palette-system/azdice/docs/js/esptool/link.txt

https://github.com/NabuCasa/esp-web-flasher
https://unpkg.com/browse/esp-web-flasher@5.1.4/dist/web/
