palette-system/azdice/firmware/azdice4/main.jpg

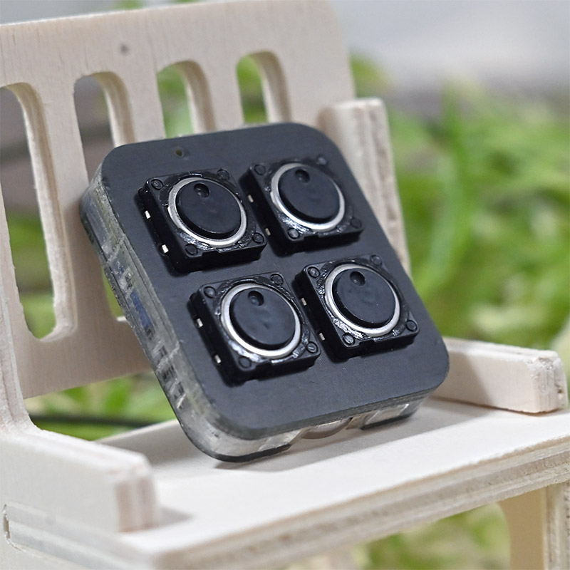
firmware/azdice4/main.jpg
