palette-system/azdice/kicad/azdice4/azdice_pcb.png

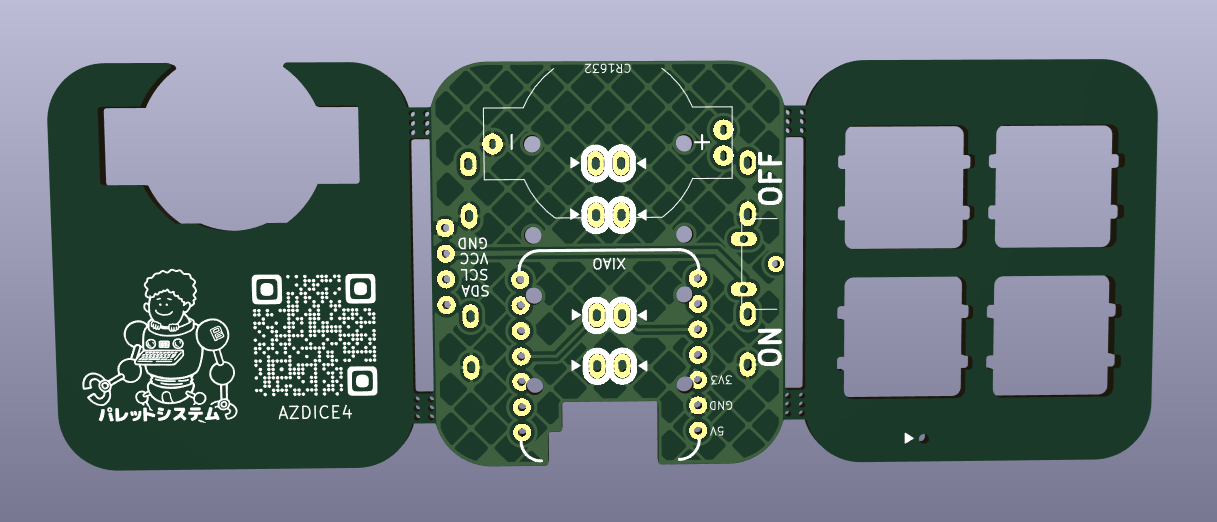
kicad/azdice4/azdice_pcb.png
