palette-system/azdice/docs/azdice4_build.html

## 必要な物

・ボンド ・マスキングテープ ・ニッパー ・ヤスリ ・はんだごて ・つまようじもあると便利

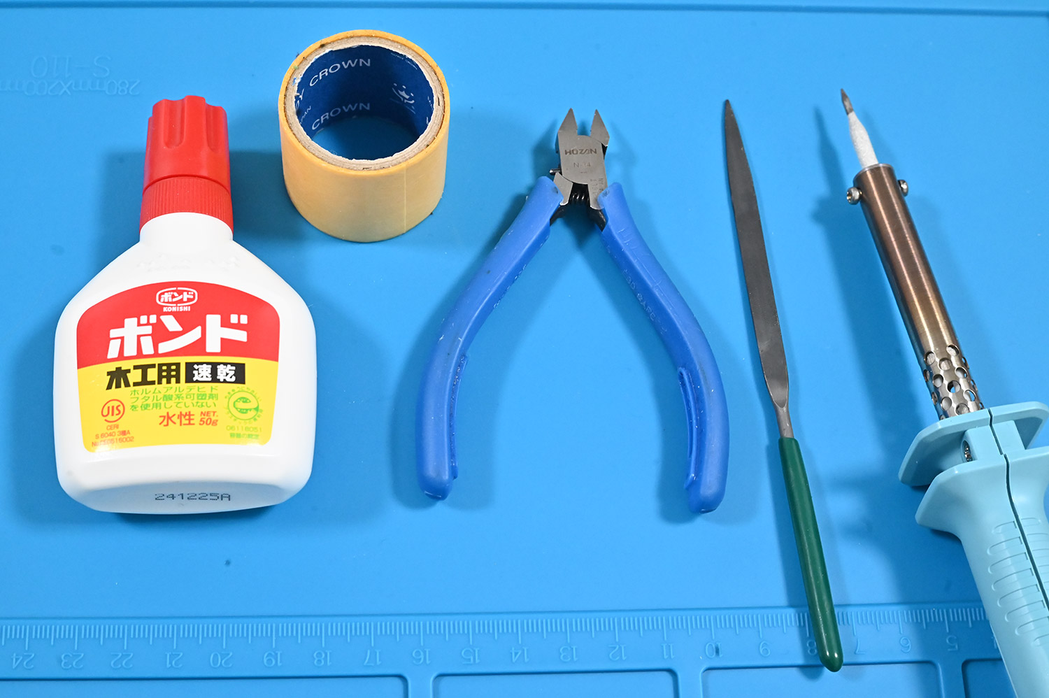
[picture p3: docs/img/azdice_4/build_00.jpg]


・Seeed XIAO BLE nRF52840 × 1個 ・アルプス12mm スイッチ × 4個

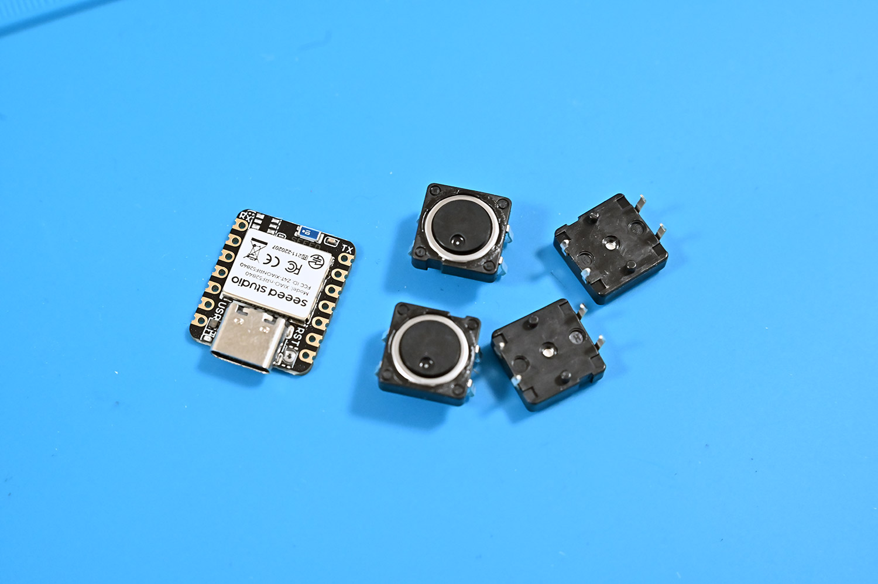
[picture p4: docs/img/azdice_4/build_02.jpg]


## 入っている物

・PCB×1 ・ボトムプレート×1 ・ミドルプレート×1 ・トッププレート×1 ・電池ホルダー×1 ・スライドスイッチ×1 ・細ピンヘッダ×2 ・輪ゴム×1

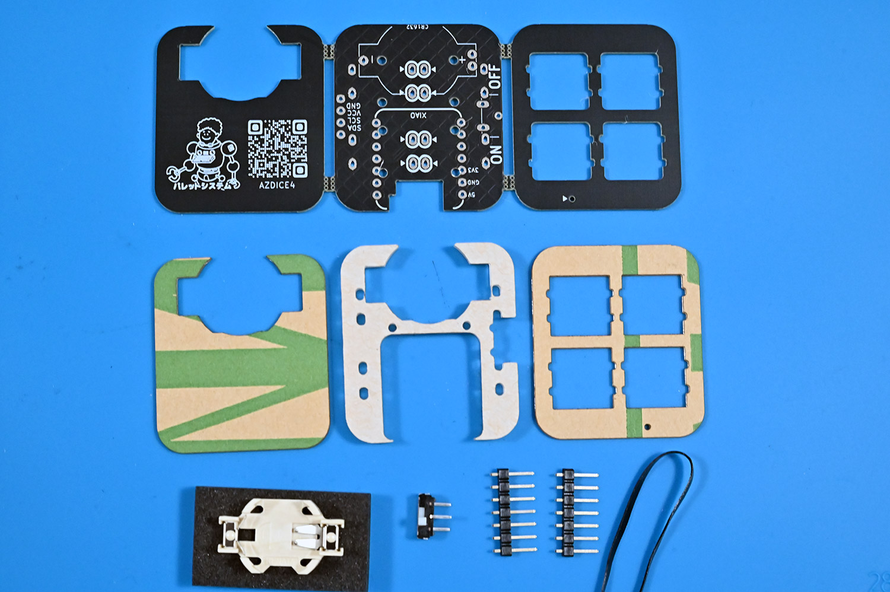
[picture p5: docs/img/azdice_4/build_01.jpg]


## １．PCBのカット

PCBを手で折って、ニッパーやヤスリで切り口を綺麗にします。

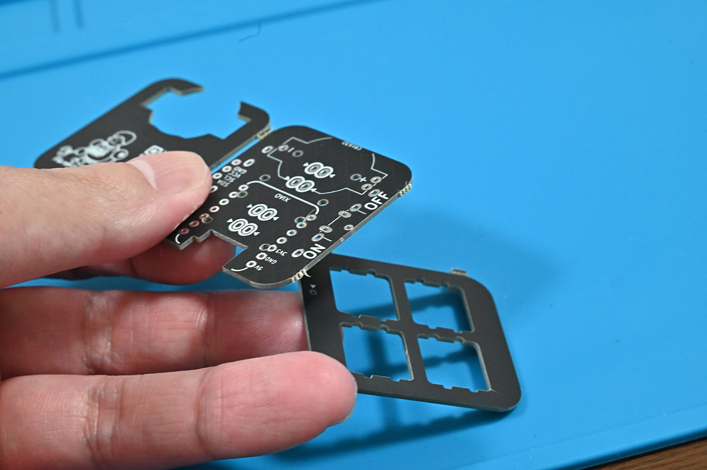
[picture p6: docs/img/azdice_4/build_03.jpg]


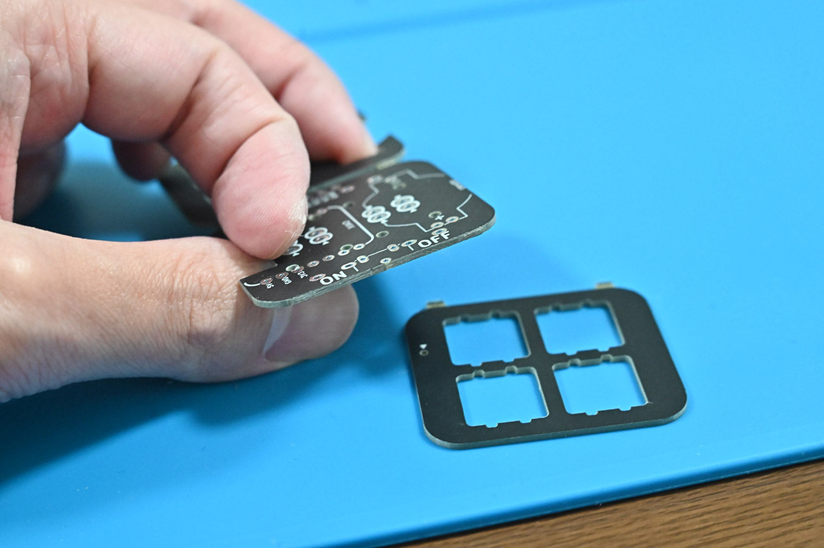
[picture p7: docs/img/azdice_4/build_04.jpg]


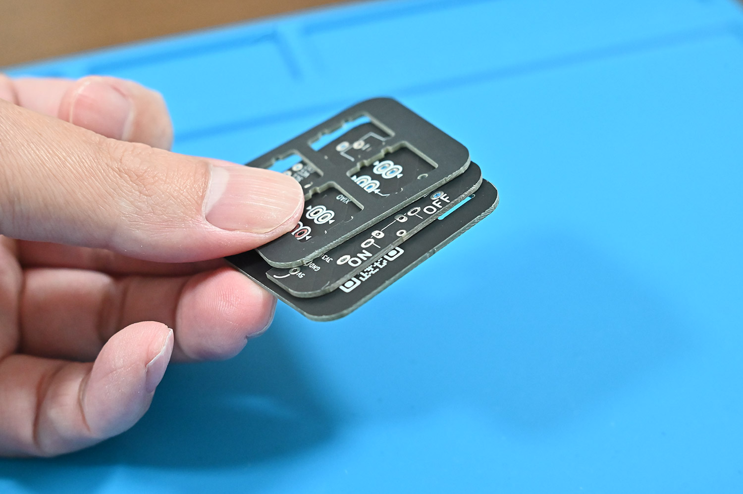
[picture p8: docs/img/azdice_4/build_05.jpg]


## ２．細ピンヘッダのカット

細ピンヘッダの短い方を1mmくらい残してカットします。

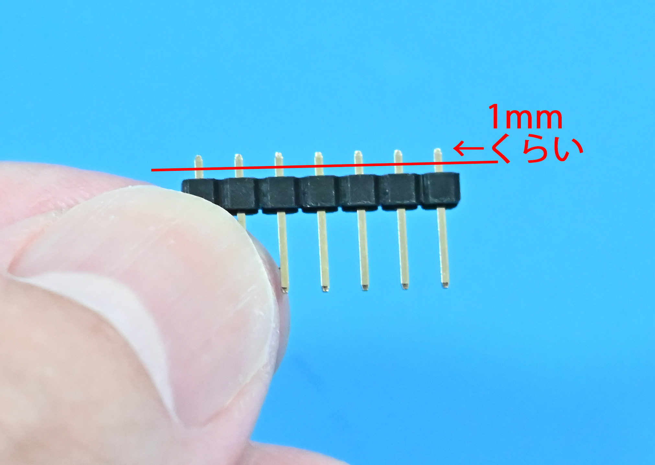
[picture p9: docs/img/azdice_4/build_06.jpg]


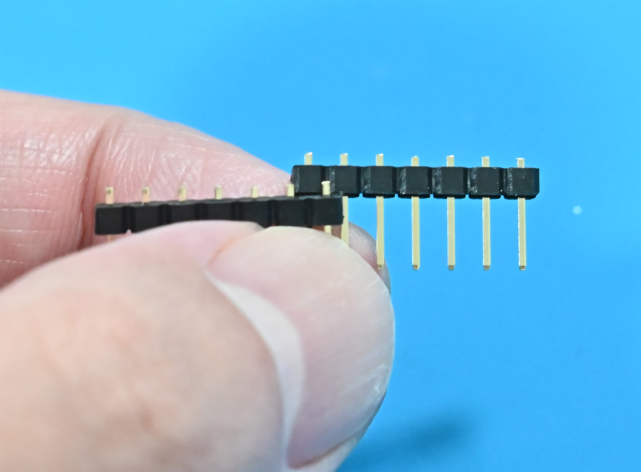
[picture p10: docs/img/azdice_4/build_07.jpg]


## ３．細ピンヘッダのはんだ付け

PCBの裏に細ピンヘッダを立てます。

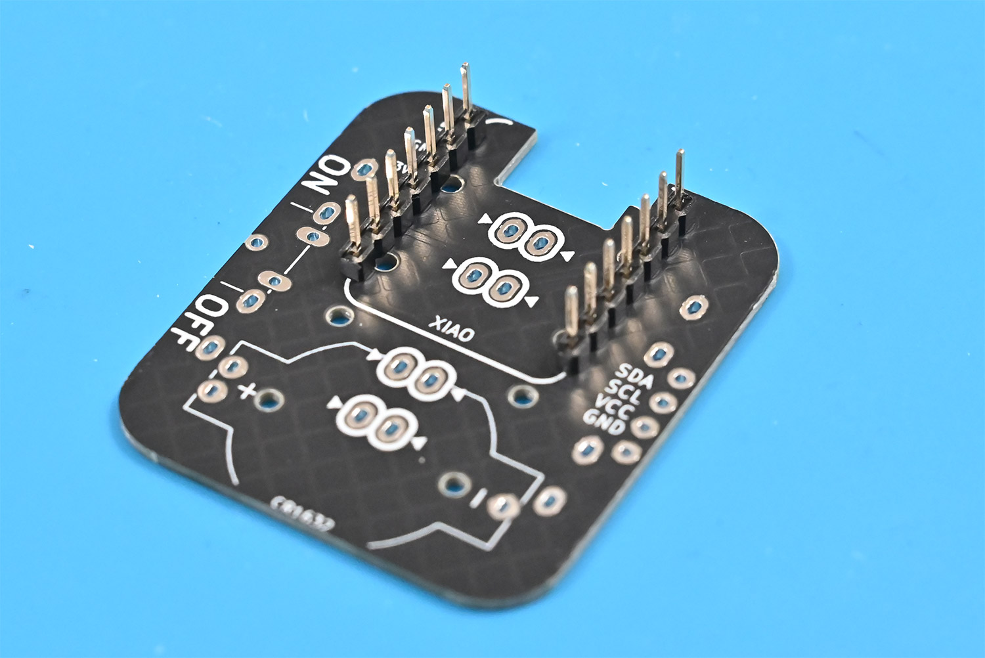
[picture p11: docs/img/azdice_4/build_08.jpg]


XIAOを乗せてゴムでとめます。

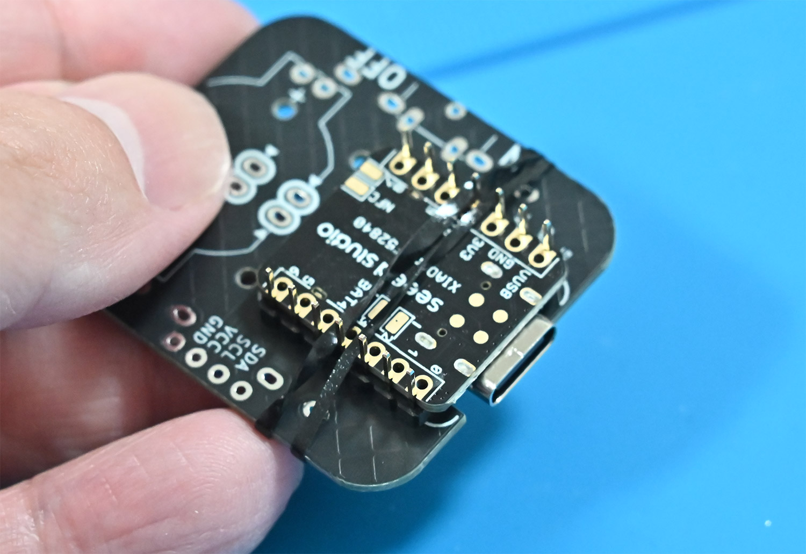
[picture p12: docs/img/azdice_4/build_09.jpg]


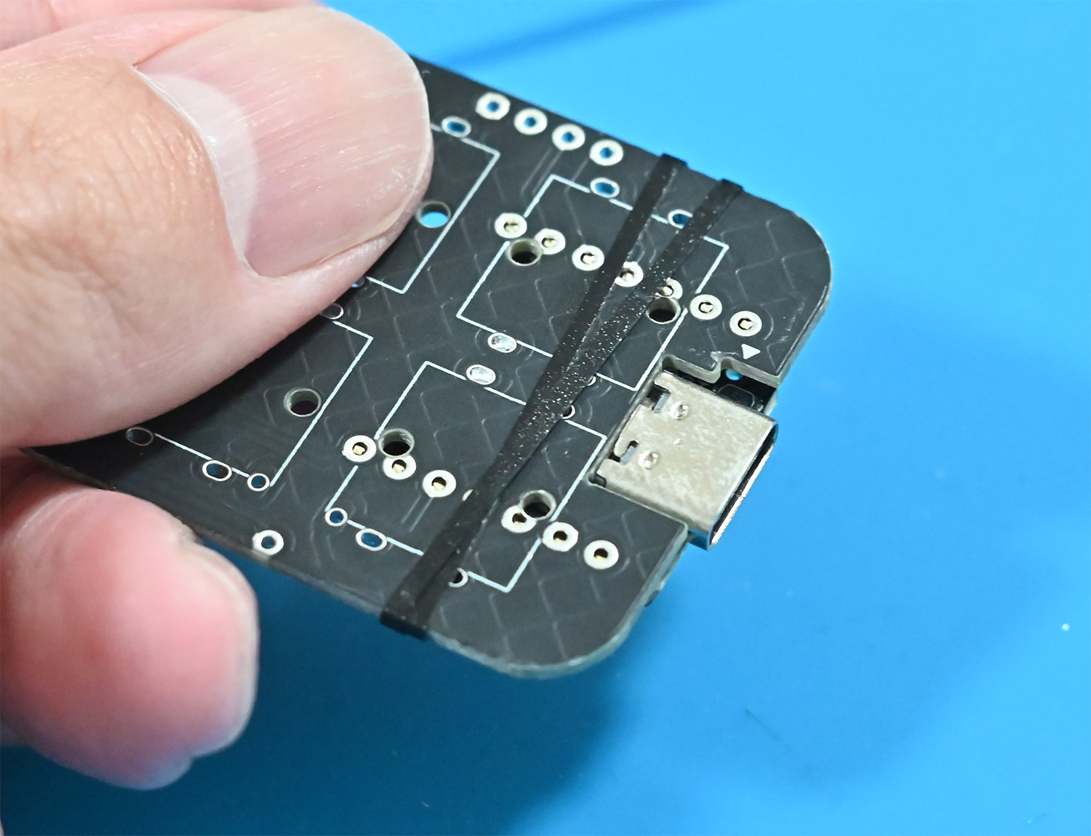
[picture p13: docs/img/azdice_4/build_10.jpg]


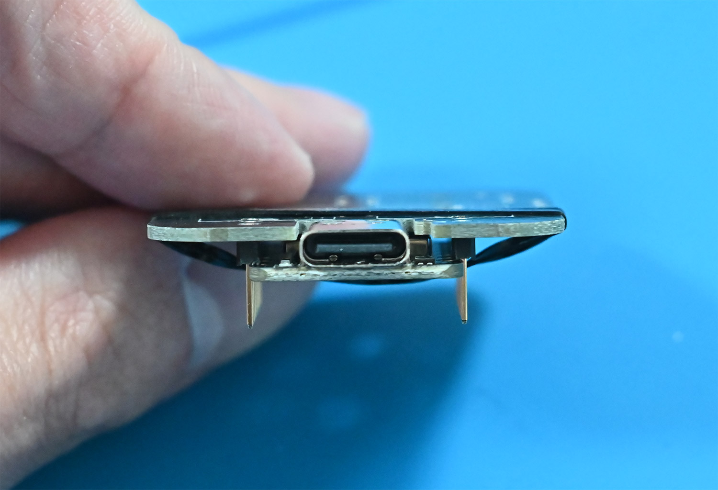
[picture p14: docs/img/azdice_4/build_11.jpg]


4つ端をはんだ付けして固定します。

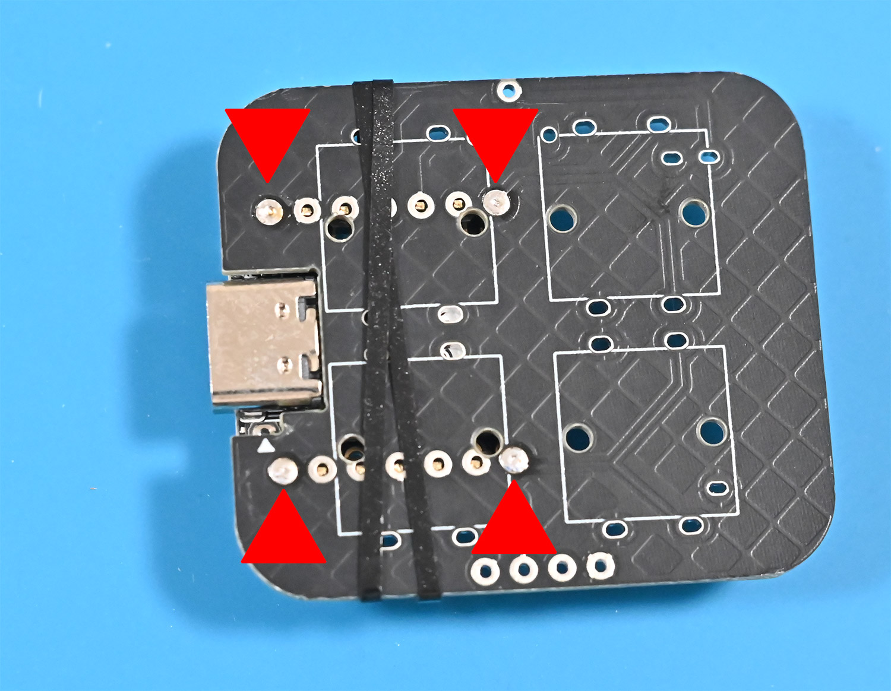
[picture p15: docs/img/azdice_4/build_12.jpg]


ゴムを外して全てのピンをはんだ付けします。
出っ張りができないようにはんだ付けして下さい。

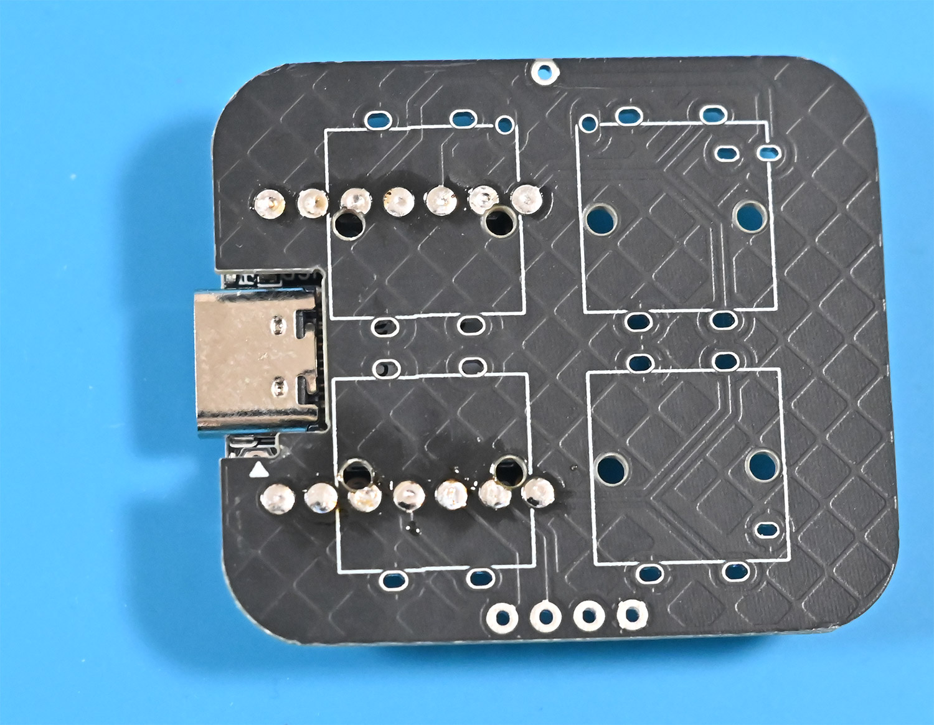
[picture p16: docs/img/azdice_4/build_13.jpg]


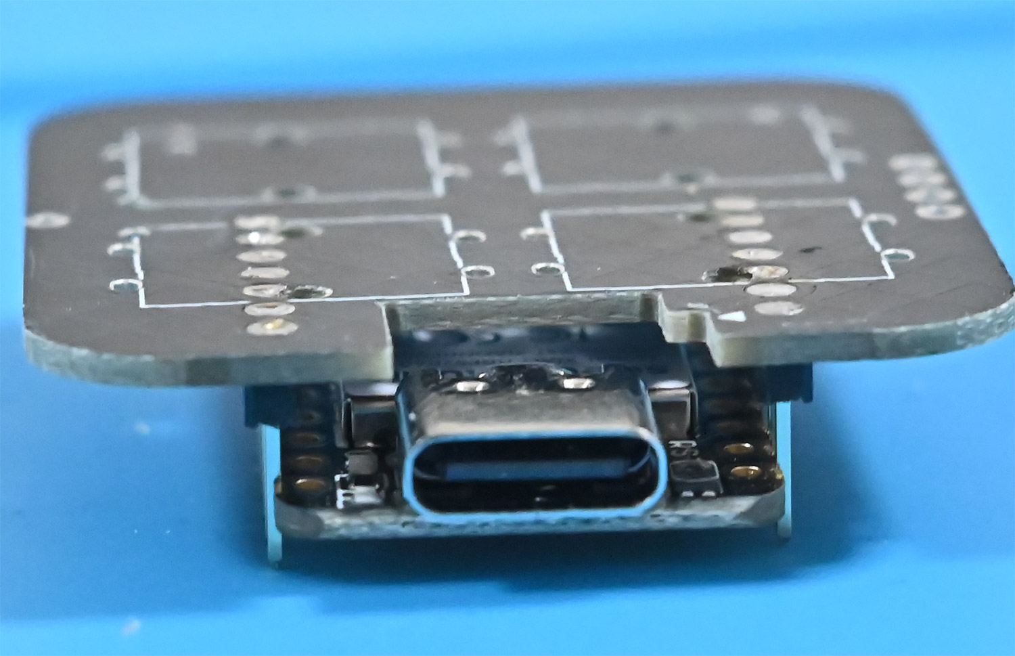
[picture p17: docs/img/azdice_4/build_14.jpg]


## ４．スイッチのカット

スイッチの足と固定用のプラスチック部分を1mmくらい残してカットします。
4個全てのスイッチを同様にカットして下さい。

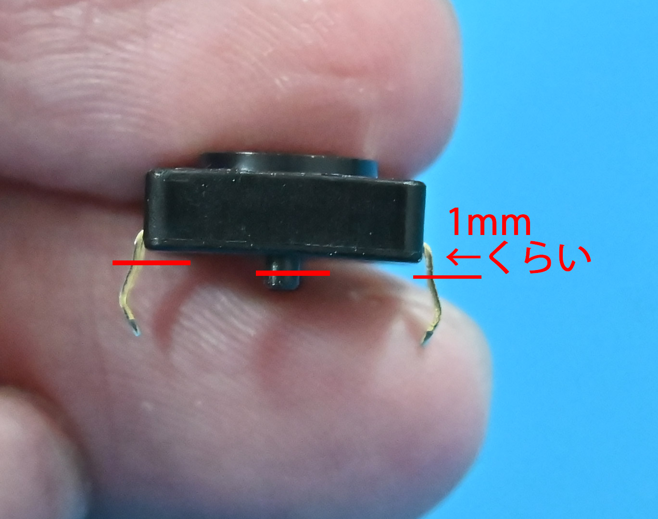
[picture p18: docs/img/azdice_4/build_15.jpg]


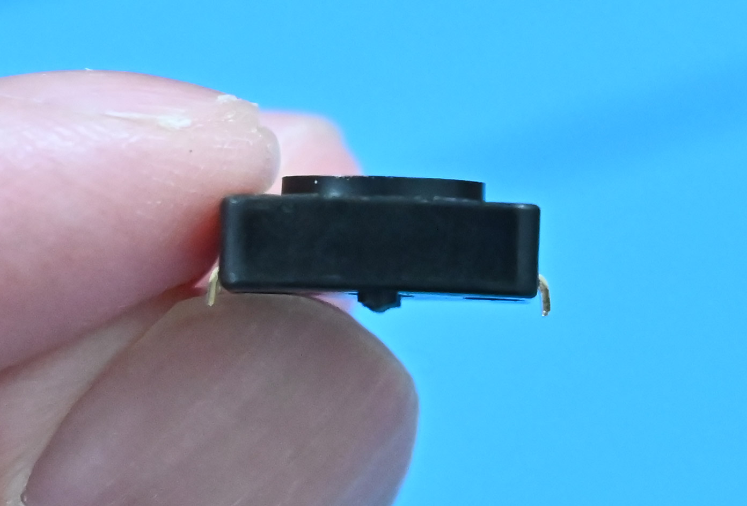
[picture p19: docs/img/azdice_4/build_16.jpg]


## ５．スイッチのはんだ付け

スイッチを固定してマスキングテープでとめます。

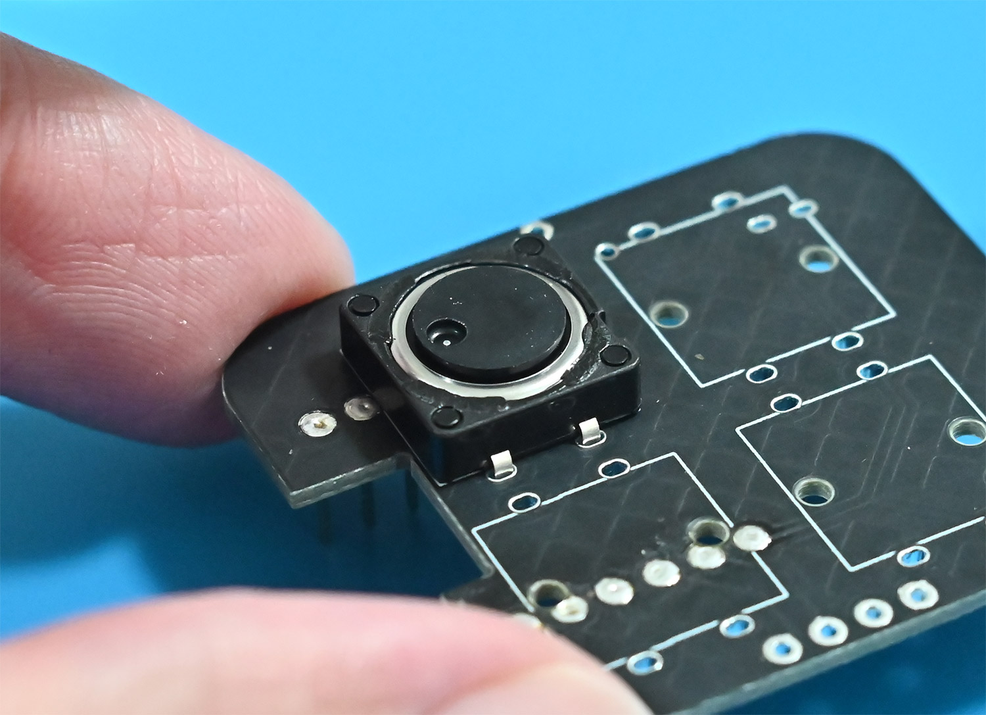
[picture p20: docs/img/azdice_4/build_17.jpg]


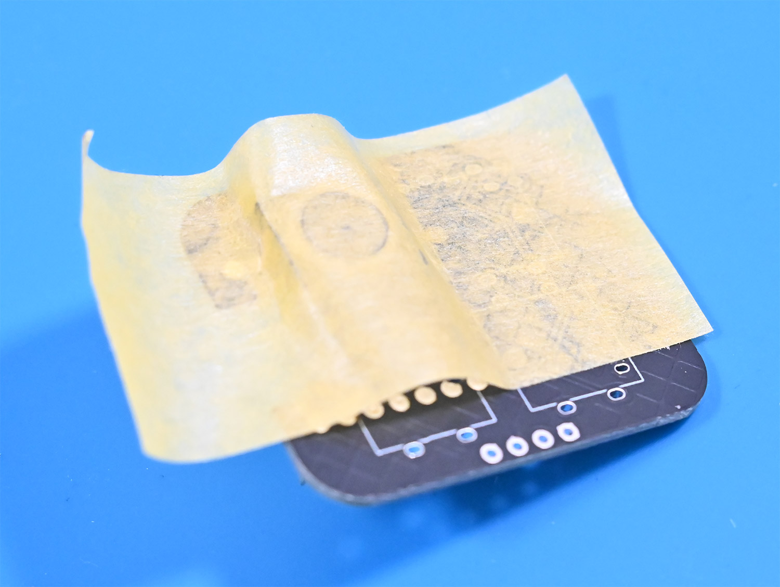
[picture p21: docs/img/azdice_4/build_18.jpg]


裏面からピンが出っ張らないようにはんだ付けします。
ピンが長すぎた場合は出っ張りができないようピンを短くカットして下さい。

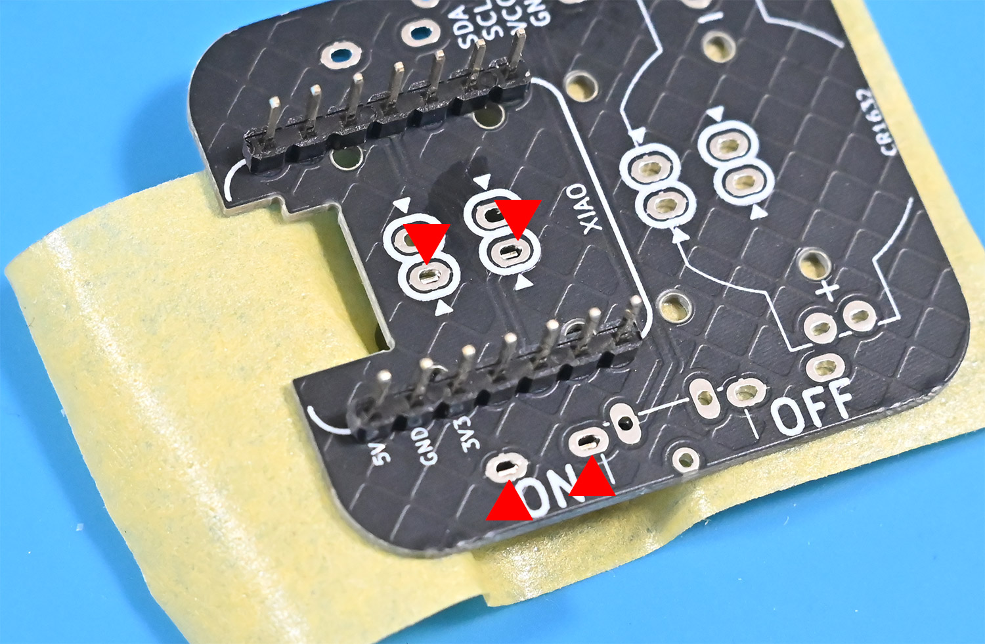
[picture p22: docs/img/azdice_4/build_19.jpg]


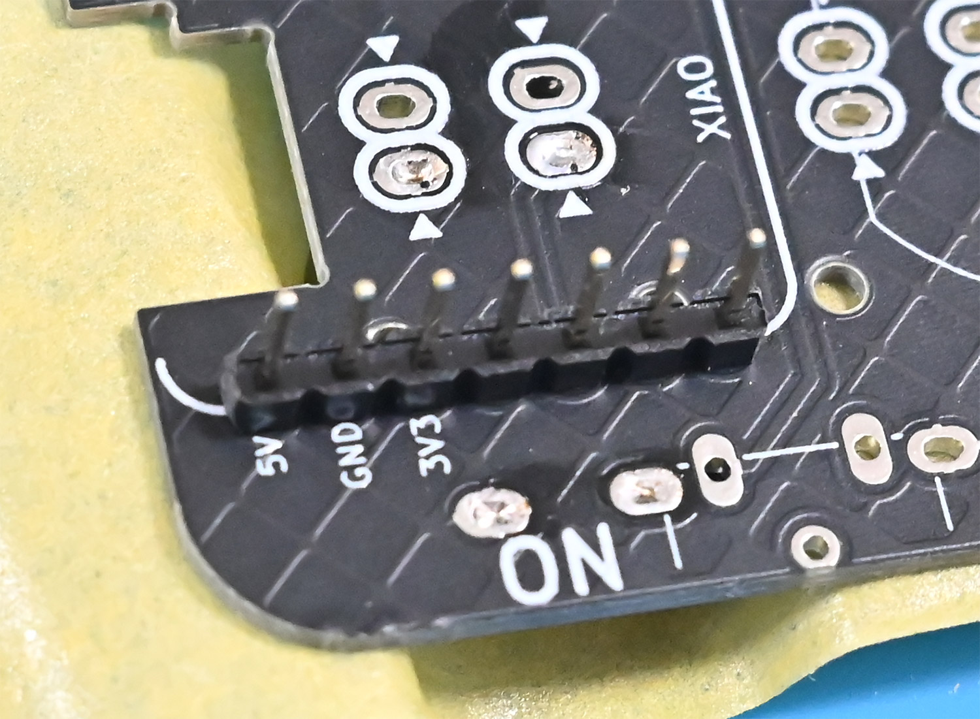
[picture p23: docs/img/azdice_4/build_20.jpg]


同様に4個全てのスイッチをはんだ付けします。

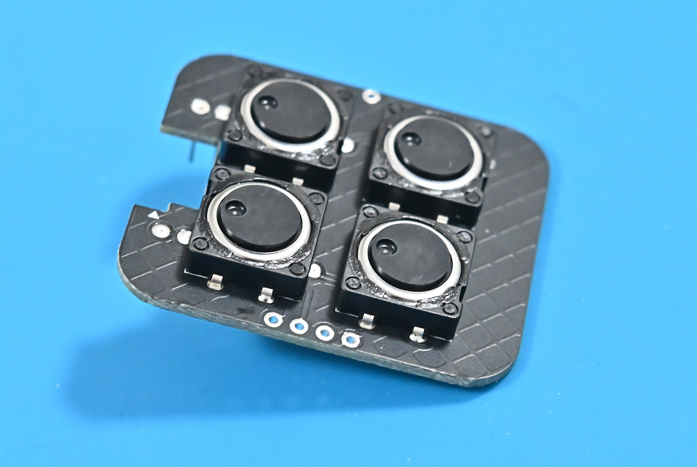
[picture p24: docs/img/azdice_4/build_21.jpg]


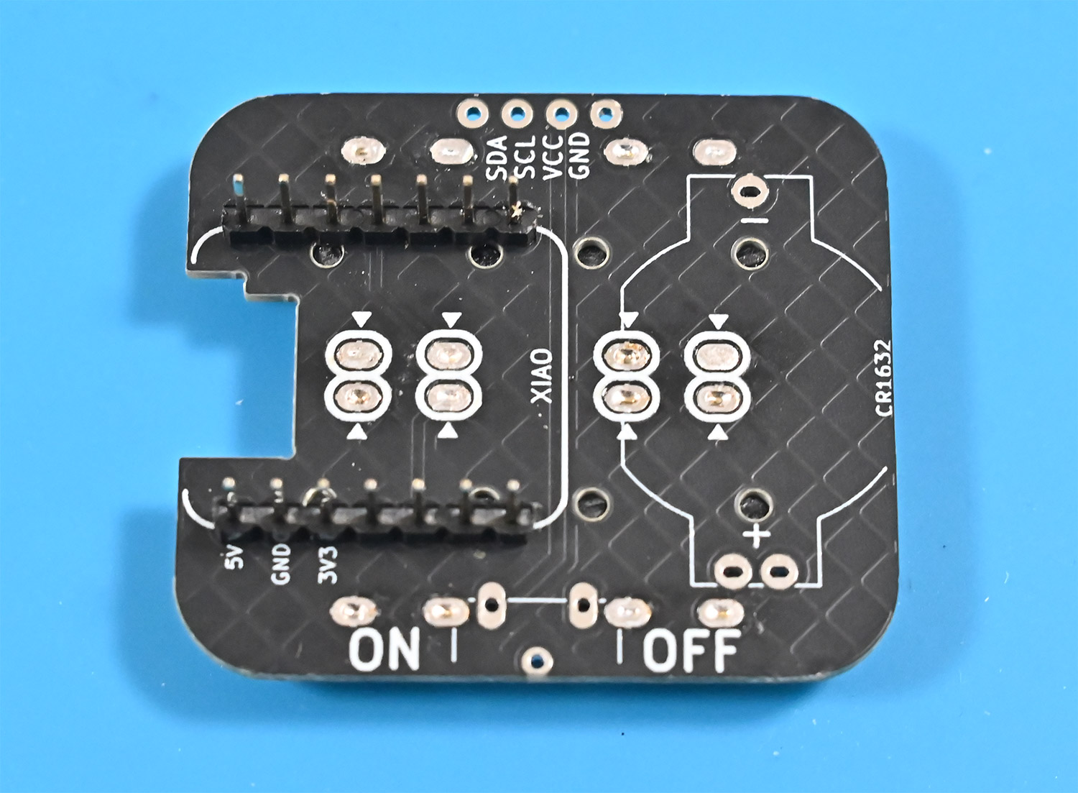
[picture p25: docs/img/azdice_4/build_22.jpg]


## ６．スライドスイッチのカット

スライドスイッチの足を1mmくらい残してカットします。

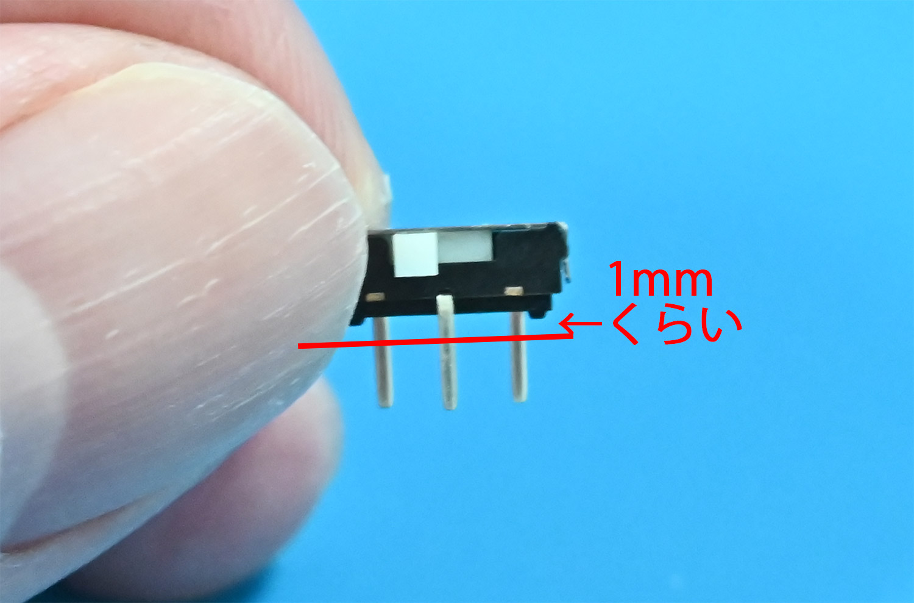
[picture p26: docs/img/azdice_4/build_23.jpg]


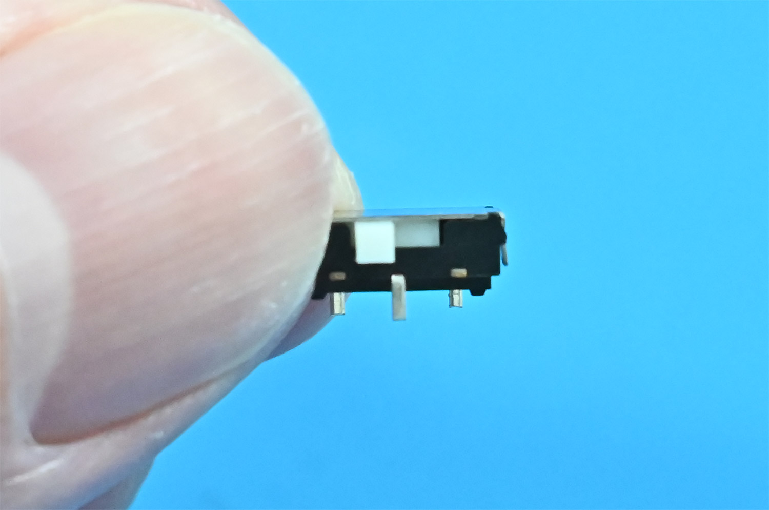
[picture p27: docs/img/azdice_4/build_24.jpg]


## ７．スライドスイッチのはんだ付け

裏面にスライドスイッチを置いて、後ろ側2か所をはんだ付けします。

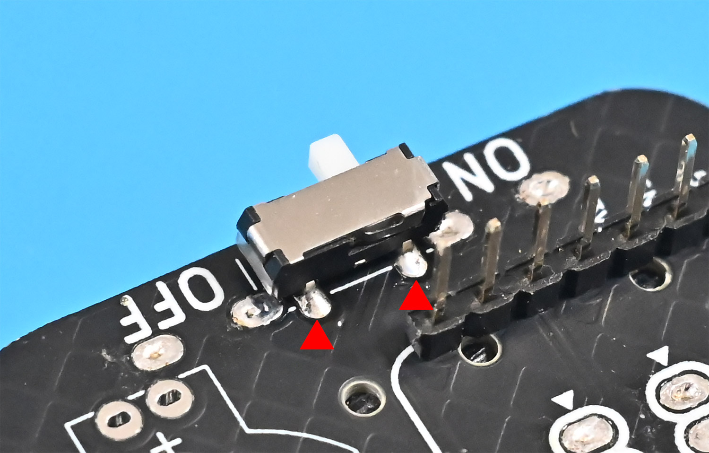
[picture p28: docs/img/azdice_4/build_25.jpg]


表面から前側1か所をはんだ付けします。

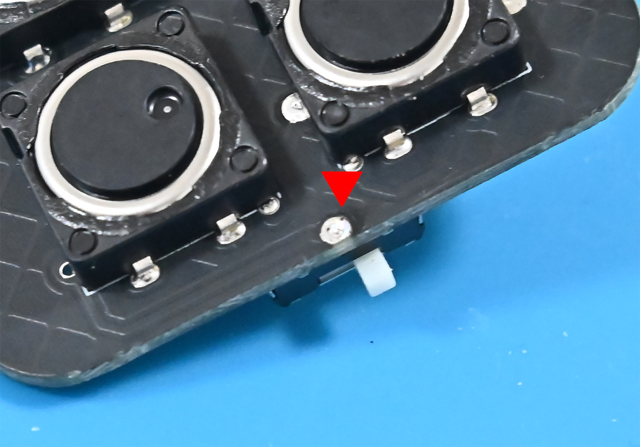
[picture p29: docs/img/azdice_4/build_26.jpg]


## ８．XIAOのはんだ付け

裏面にXIAOを置いて、細ピンヘッダの出っ張ってる部分をカットします。
出っ張りができないようにカットして下さい。

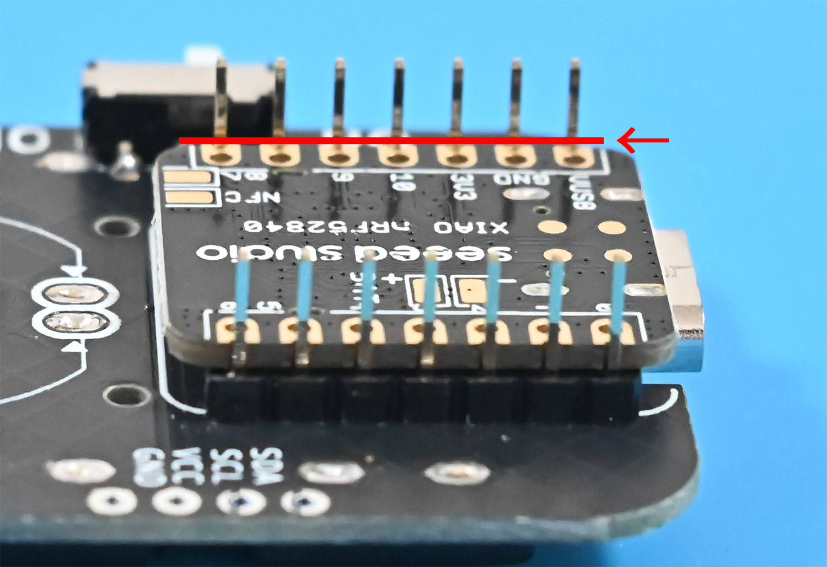
[picture p30: docs/img/azdice_4/build_27.jpg]


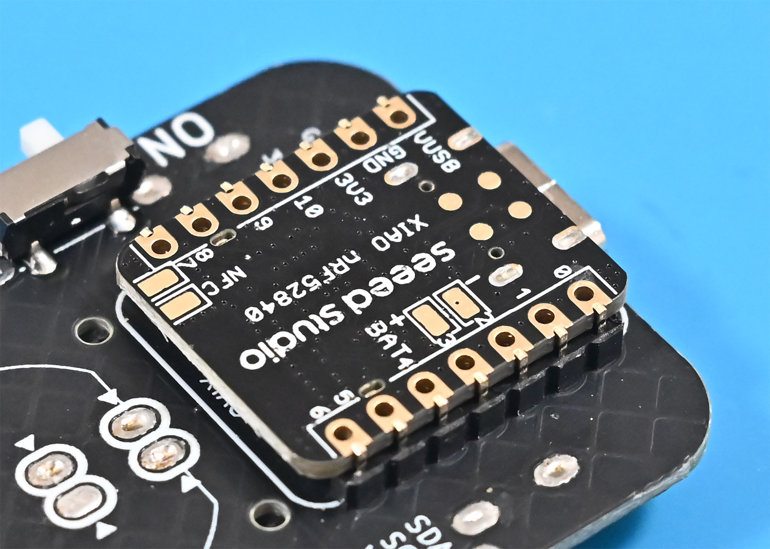
[picture p31: docs/img/azdice_4/build_28.jpg]


細ピンヘッダとXIAOをはんだ付けします。

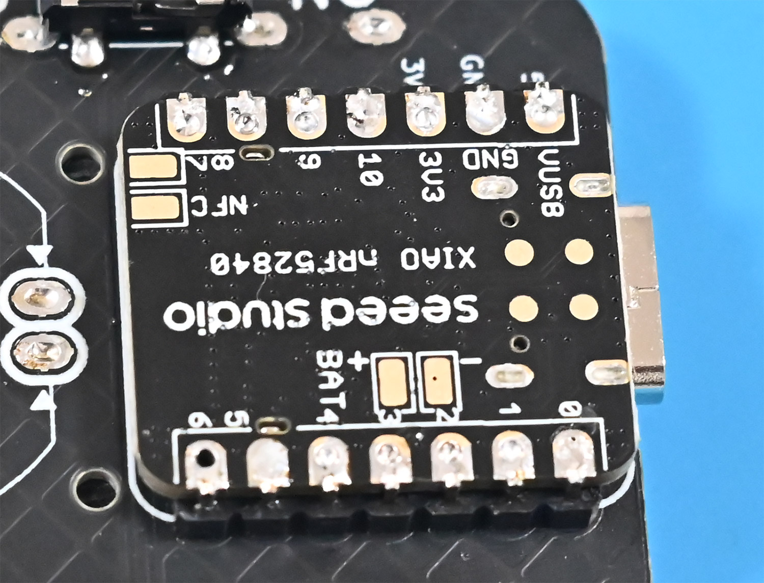
[picture p32: docs/img/azdice_4/build_29.jpg]


## ９．電池ホルダーのはんだ付け

電池ホルダーの足を1mmくらい残してカットします。

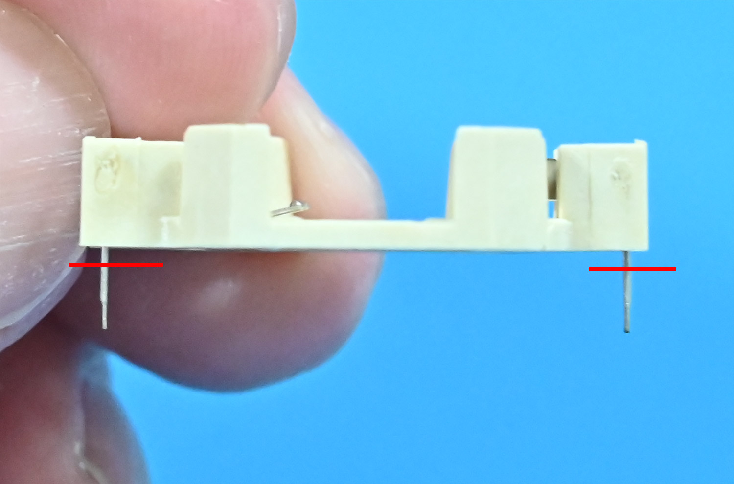
[picture p33: docs/img/azdice_4/build_30.jpg]


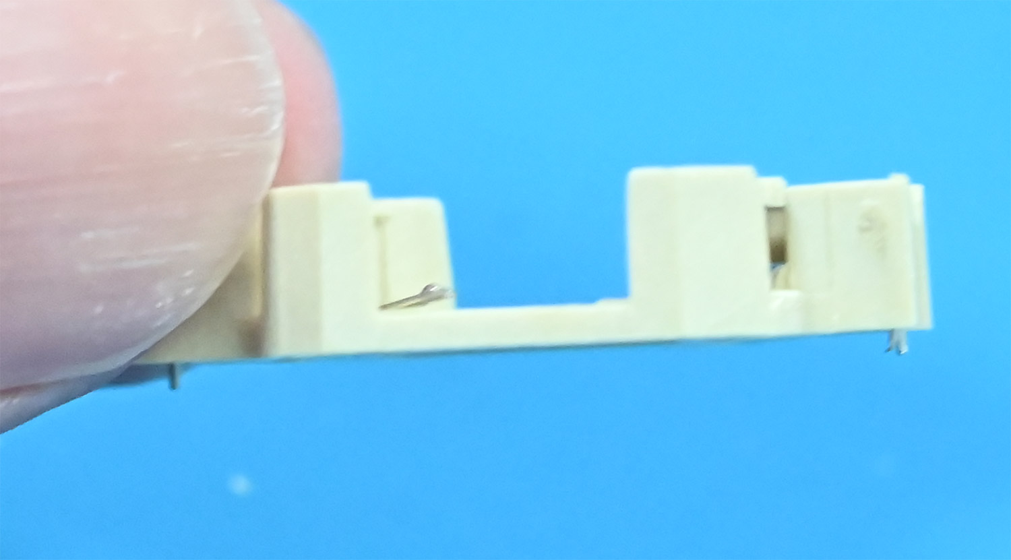
[picture p34: docs/img/azdice_4/build_31.jpg]


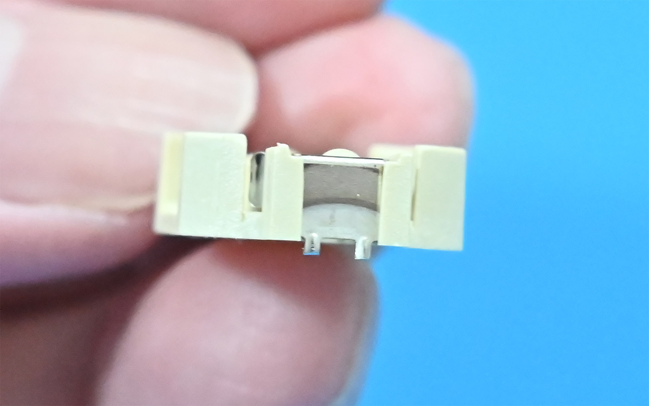
[picture p35: docs/img/azdice_4/build_32.jpg]


PCBの裏面に電池ホルダーを置いて両端をはんだ付けして下さい。

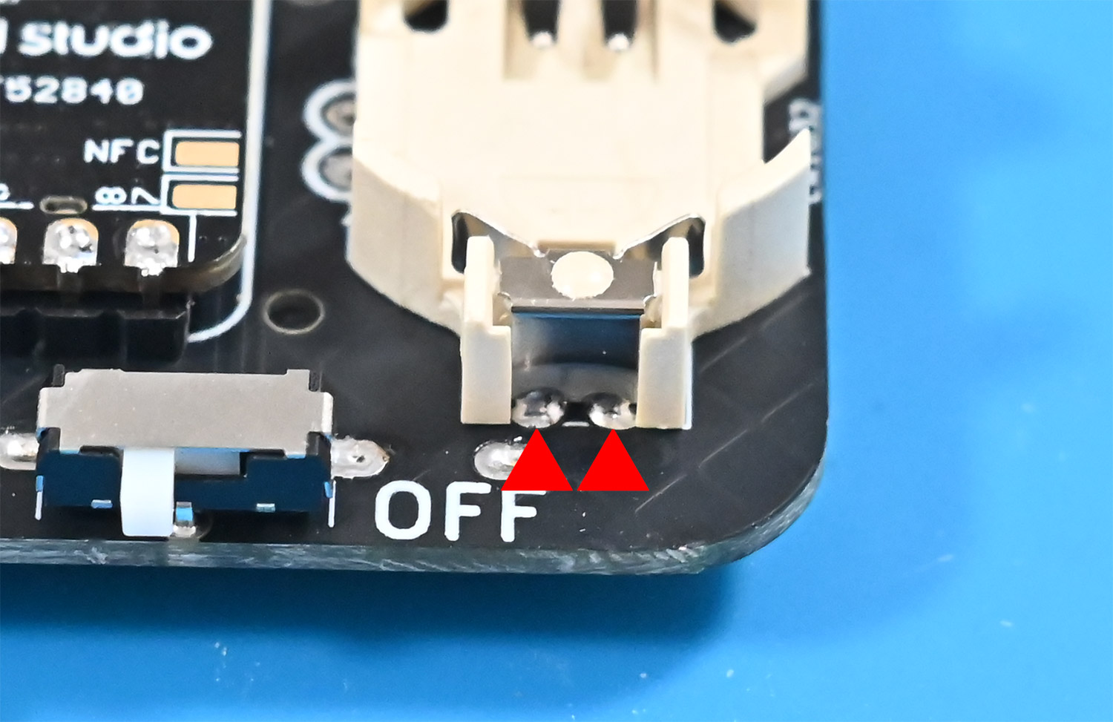
[picture p36: docs/img/azdice_4/build_33.jpg]


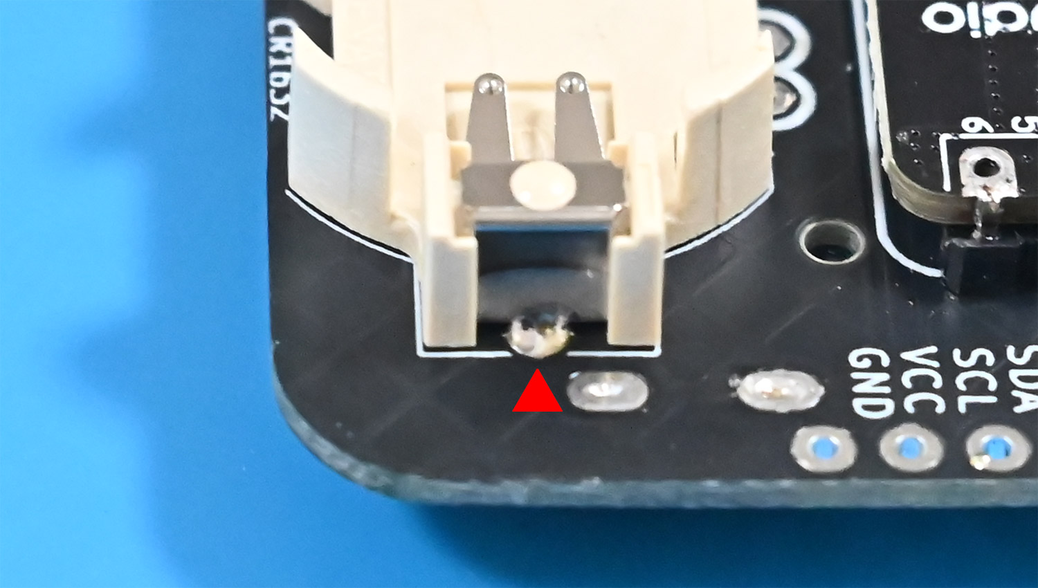
[picture p37: docs/img/azdice_4/build_34.jpg]


## １０．ファームウェアの書き込み

XIAOをPCに接続して、下記リンク先を参考にファームウェアを書き込んでキーボードとして動作する事を確認して下さい。

ファームウェア書込 (https://palette-system.github.io/azk/nrf52840.html)

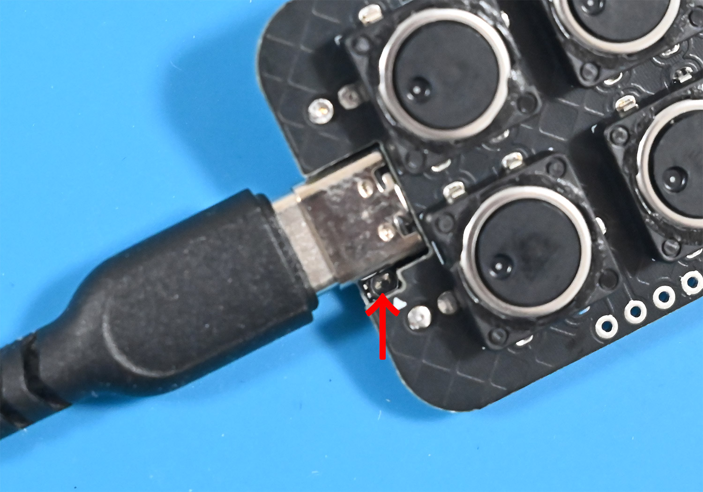
[picture p38: docs/img/azdice_4/build_35.jpg]


## １１．プレートの仮止め

使用するプレートの保護シートを剥がします。

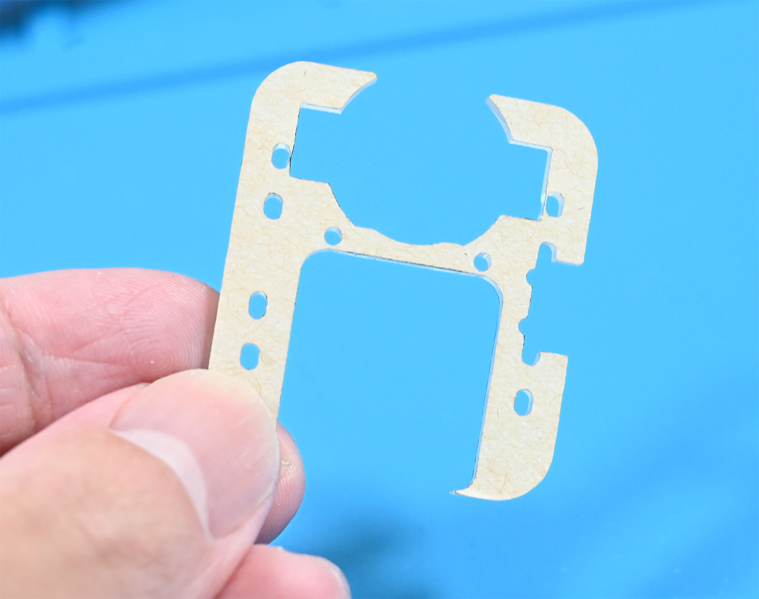
[picture p39: docs/img/azdice_4/build_36.jpg]


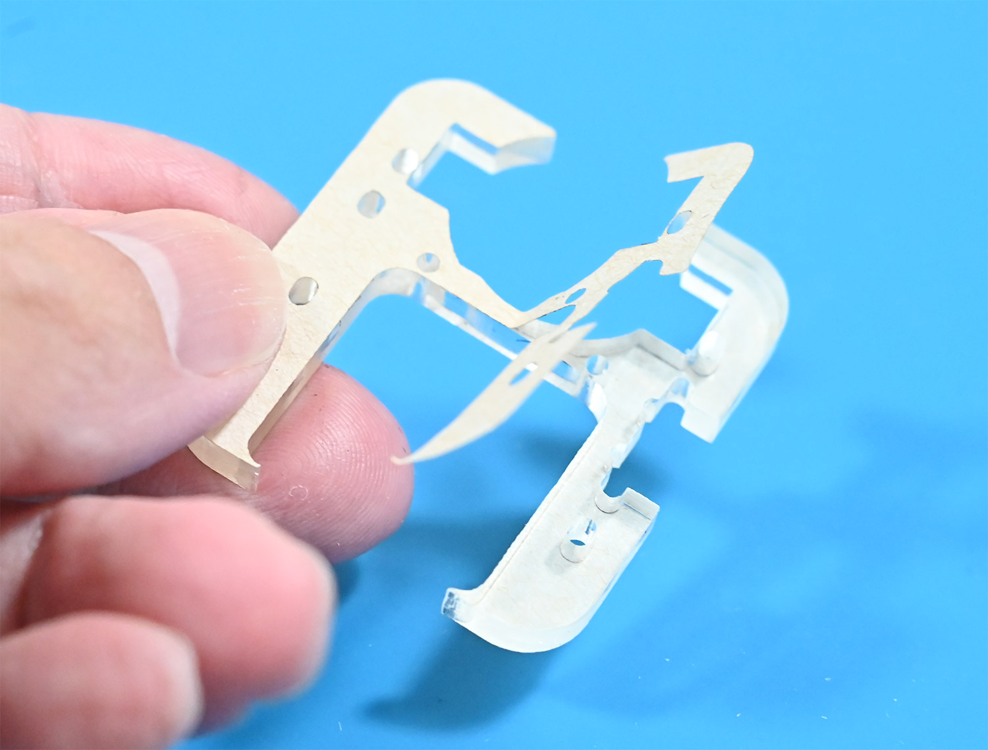
[picture p40: docs/img/azdice_4/build_37.jpg]


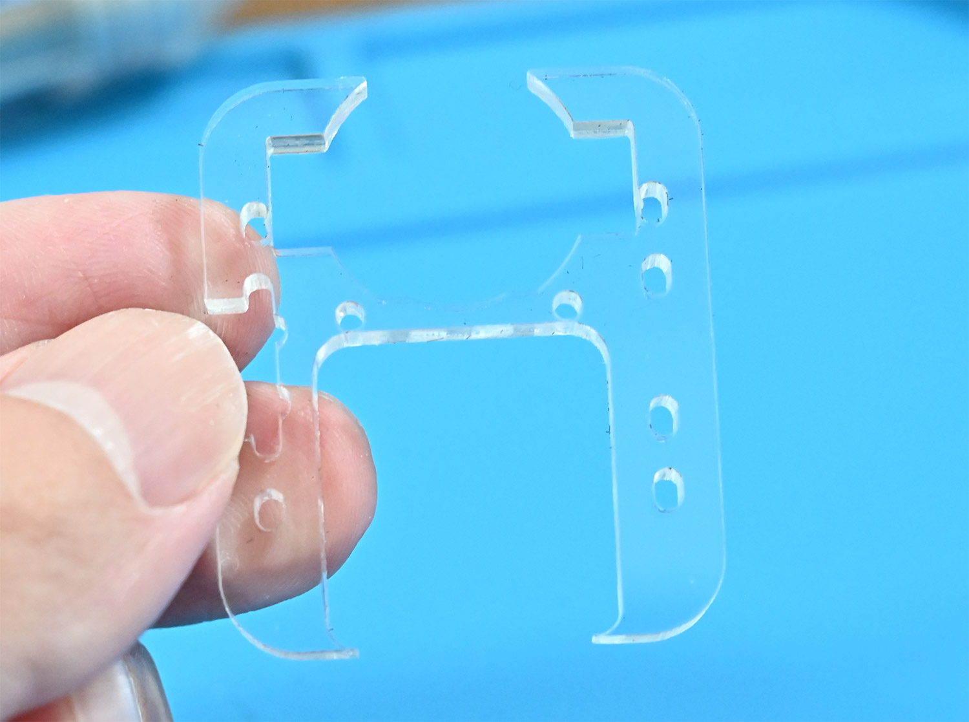
[picture p41: docs/img/azdice_4/build_38.jpg]


裏面にミドルプレートを重ねます。

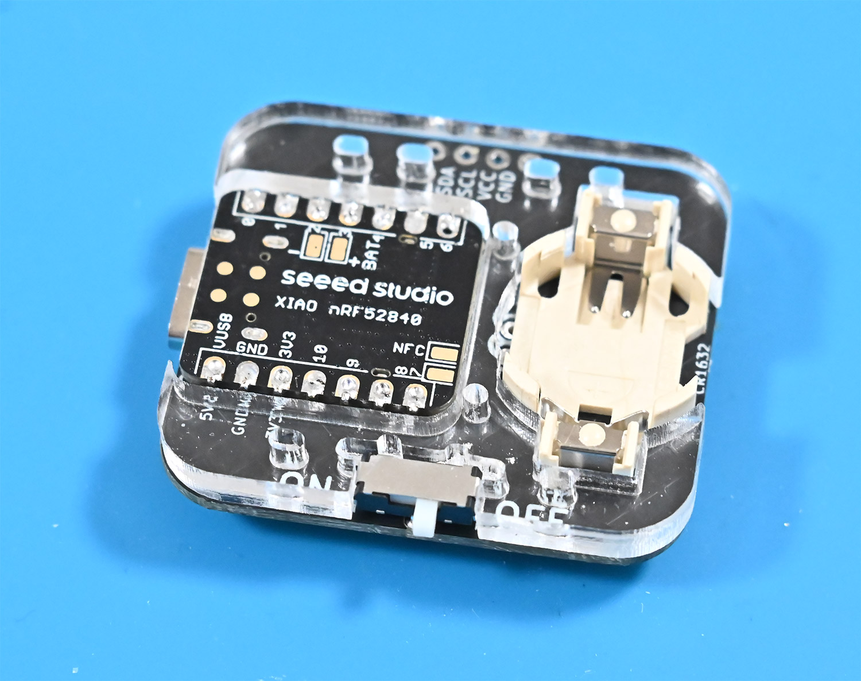
[picture p42: docs/img/azdice_4/build_39.jpg]


ミドルプレートの上にボトムプレートを重ねます。
※透明にしたい場合はアクリルのボトムプレートを重ねて下さい。

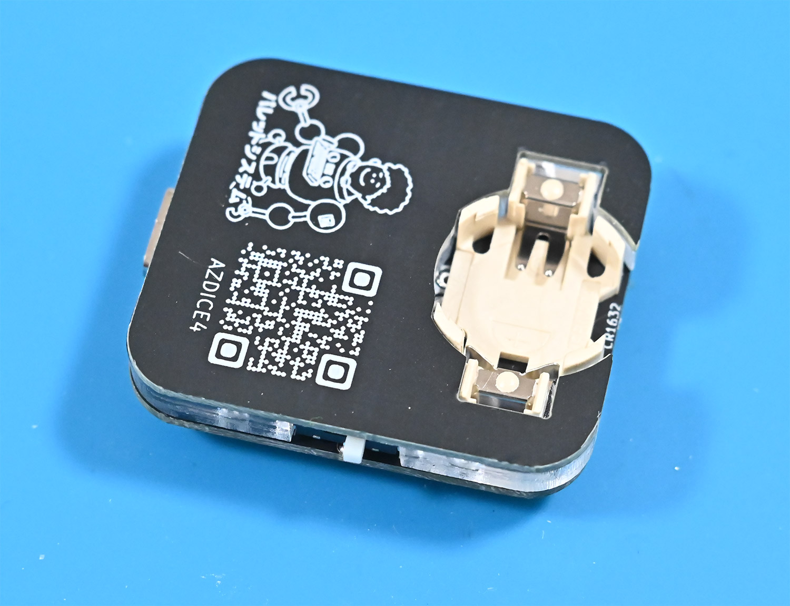
[picture p43: docs/img/azdice_4/build_40.jpg]


表面にしてトッププレートを重ねます。
XIAOのリセットボタンを押す用の穴があるので向きに気を付けて下さい。
※透明にしたい場合はアクリルのトッププレートを重ねて下さい。

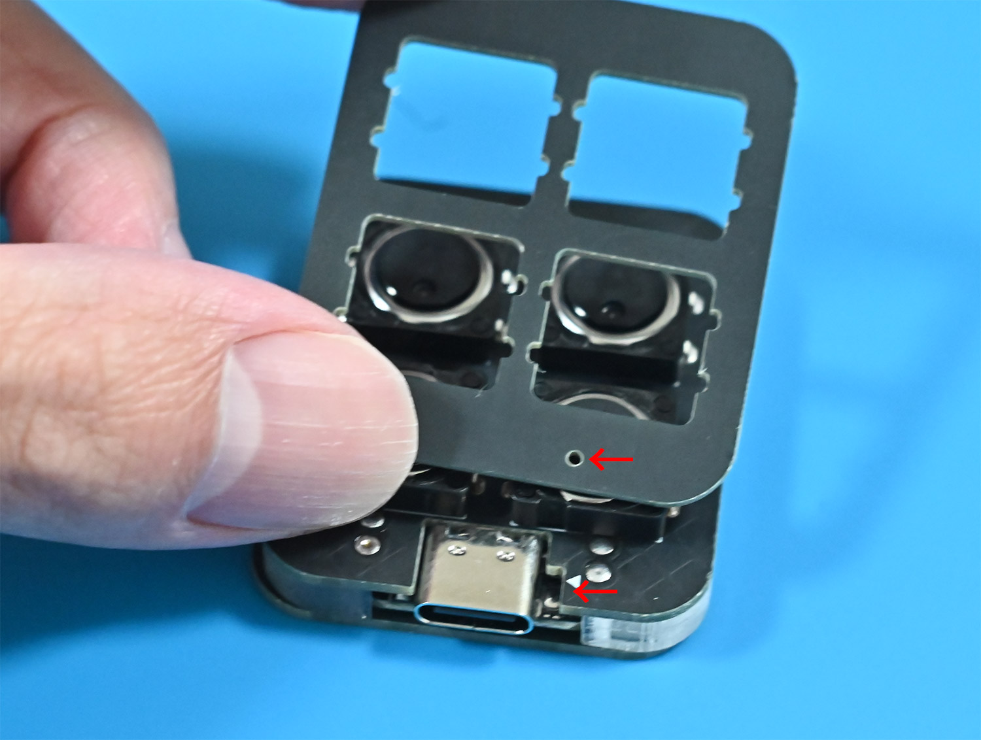
[picture p44: docs/img/azdice_4/build_41.jpg]


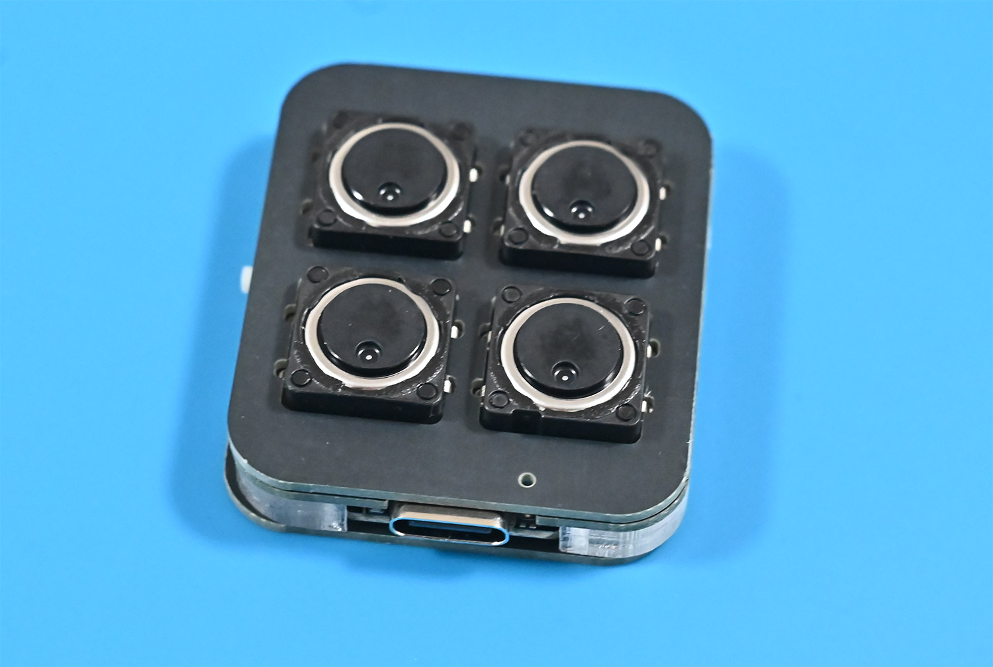
[picture p45: docs/img/azdice_4/build_42.jpg]


マスキングテープで左右を止めて下さい。

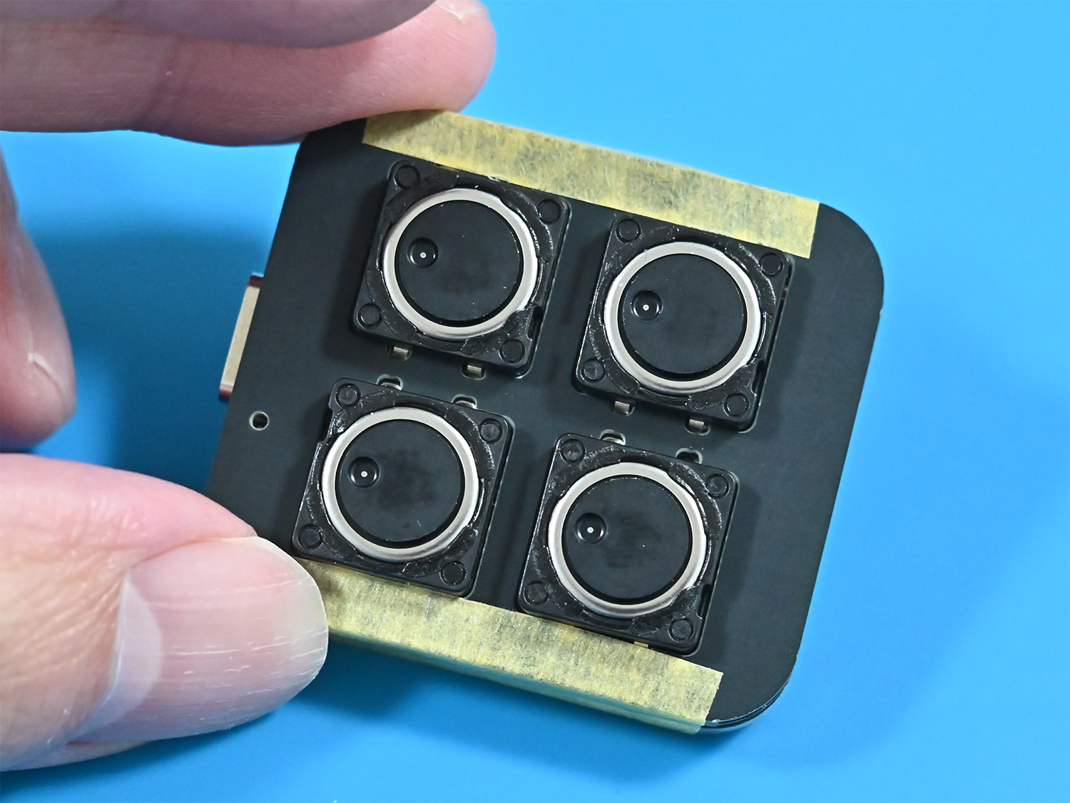
[picture p46: docs/img/azdice_4/build_43.jpg]


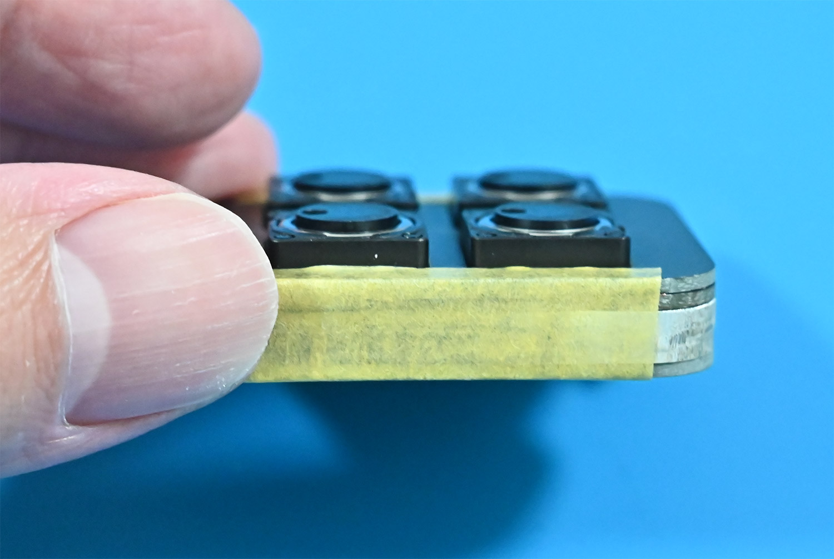
[picture p47: docs/img/azdice_4/build_44.jpg]


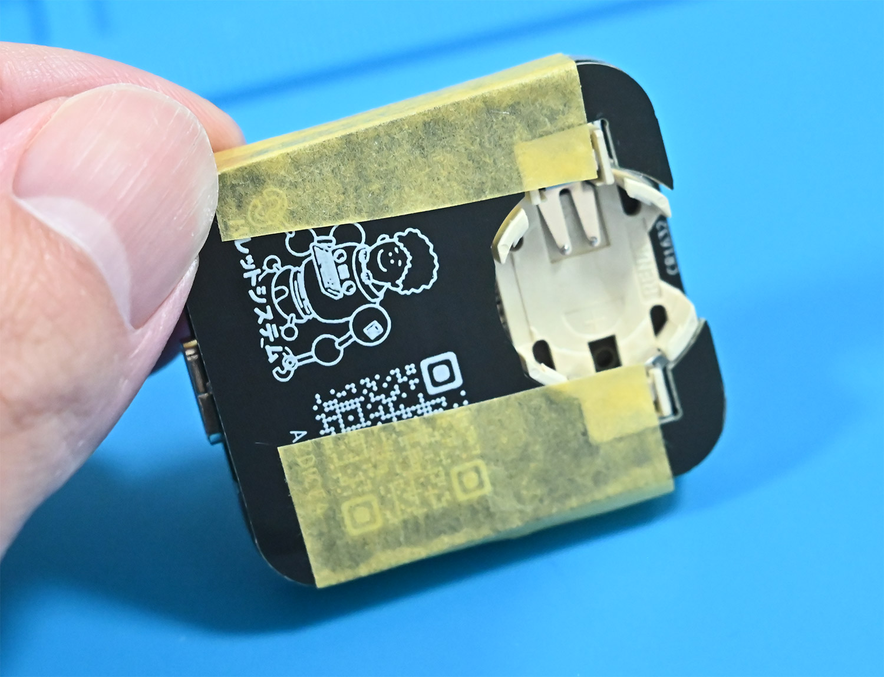
[picture p48: docs/img/azdice_4/build_45.jpg]


## １２．プレートの固定

上側、下側の側面にボンドを乗せ、つまようじなどで伸ばして下さい。

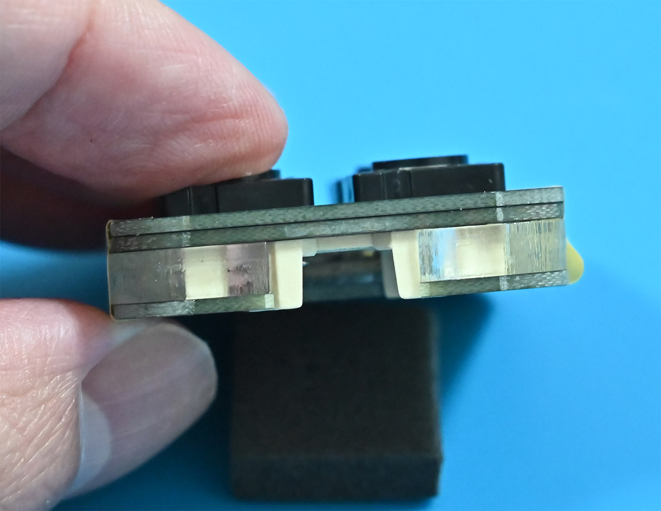
[picture p49: docs/img/azdice_4/build_46.jpg]


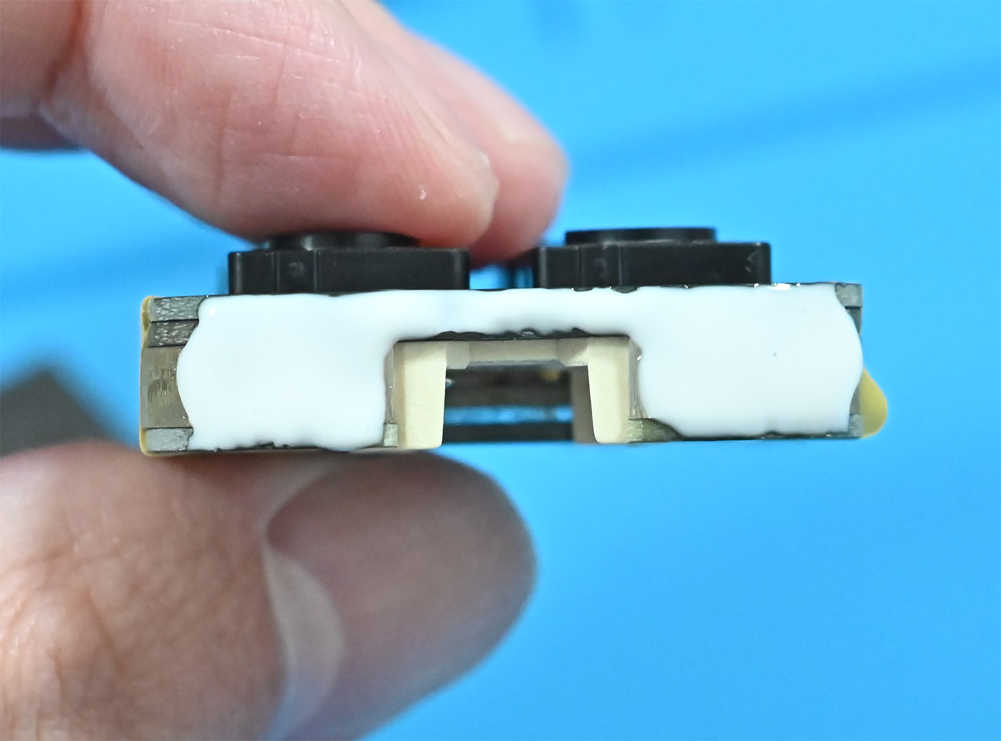
[picture p50: docs/img/azdice_4/build_47.jpg]


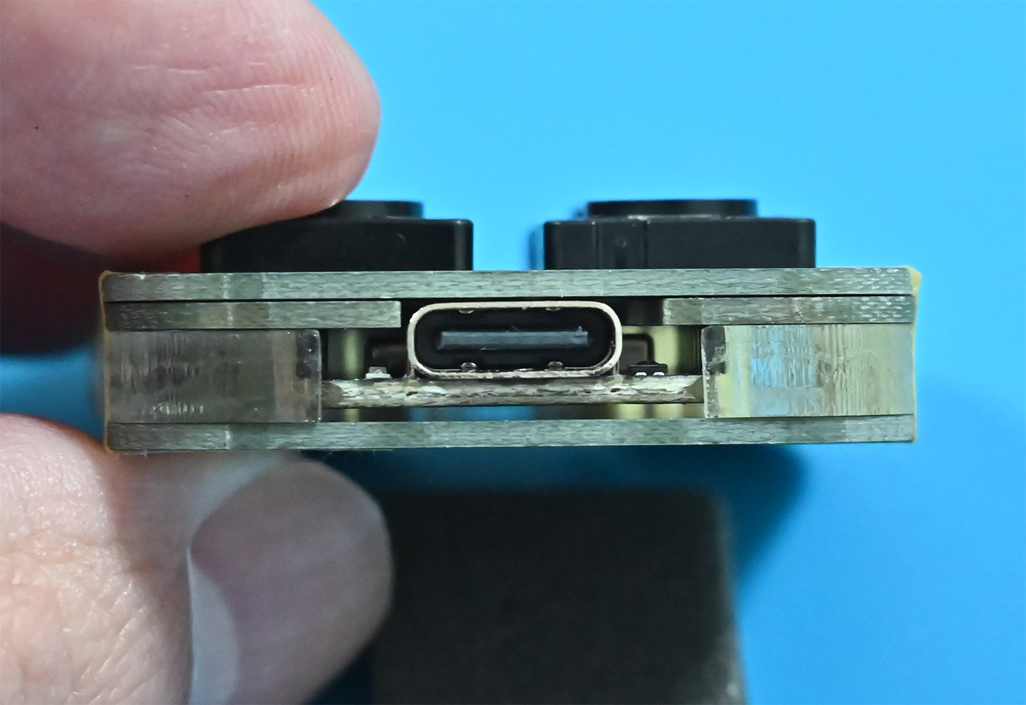
[picture p51: docs/img/azdice_4/build_48.jpg]


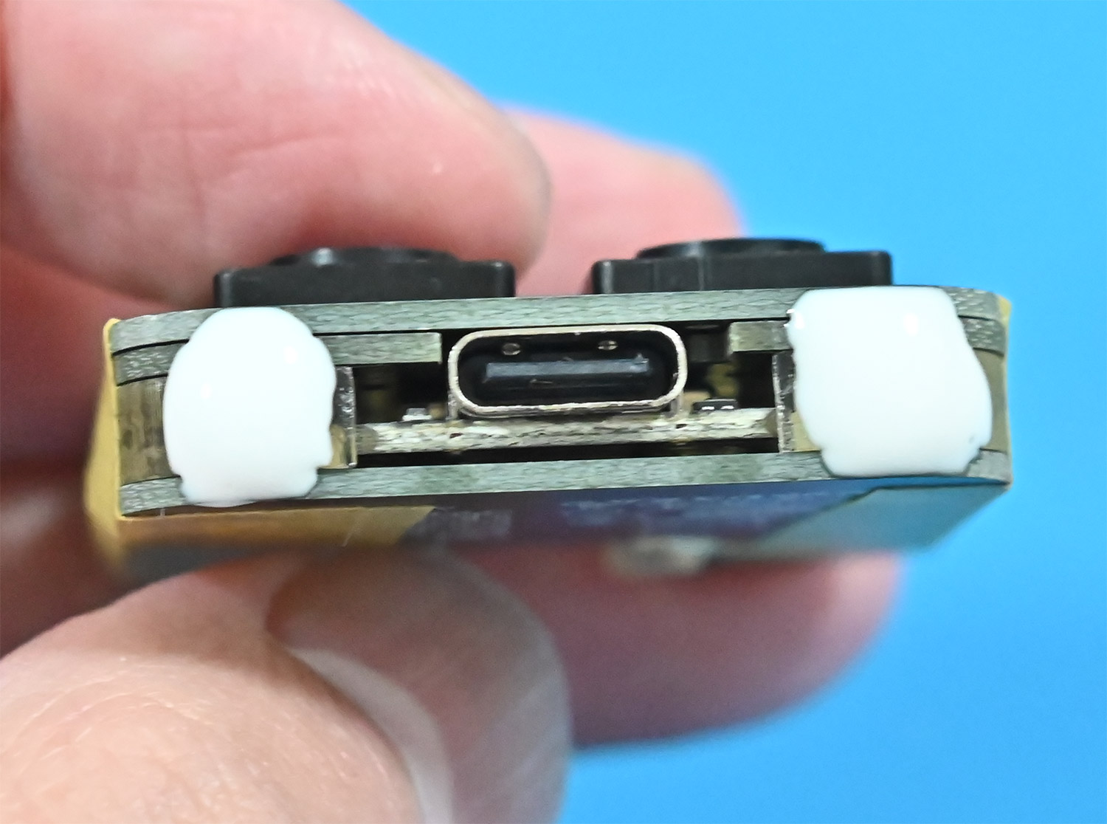
[picture p52: docs/img/azdice_4/build_49.jpg]


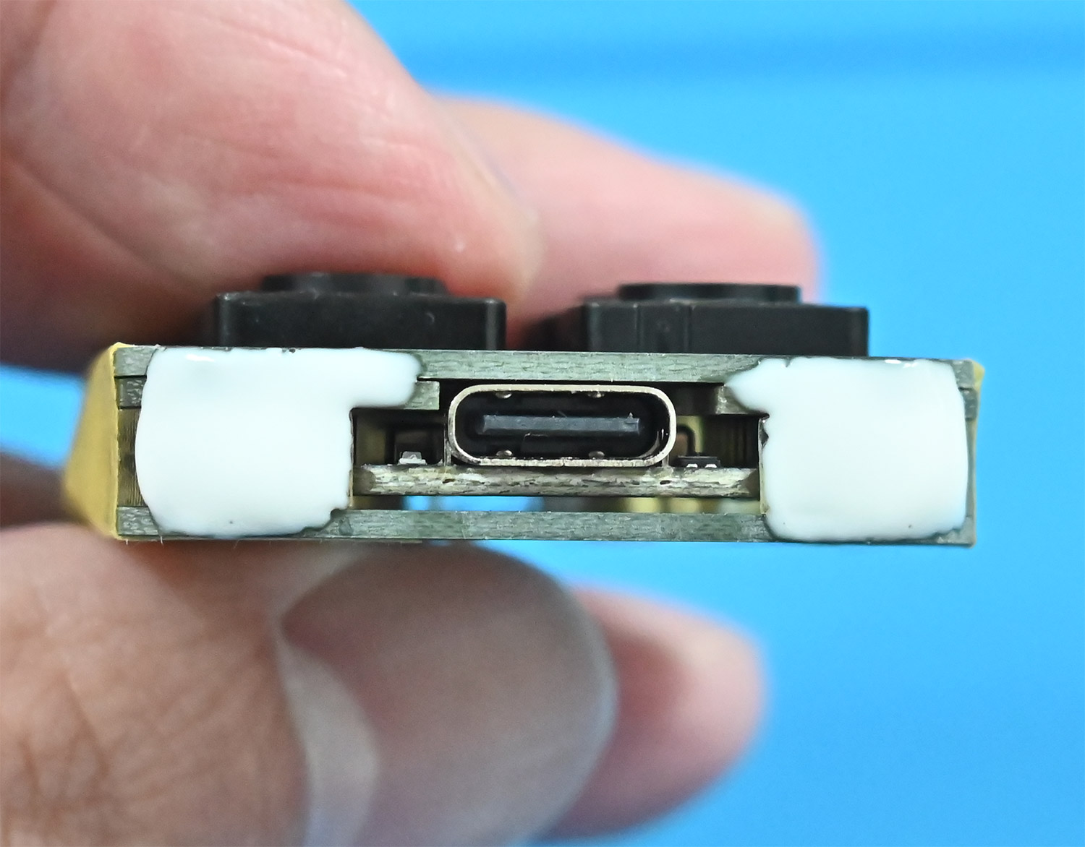
[picture p53: docs/img/azdice_4/build_50.jpg]


そのままボンドが透明になるまで数時間置いて乾かして下さい。
ドライヤーなどで乾かすと短い時間で乾きます。

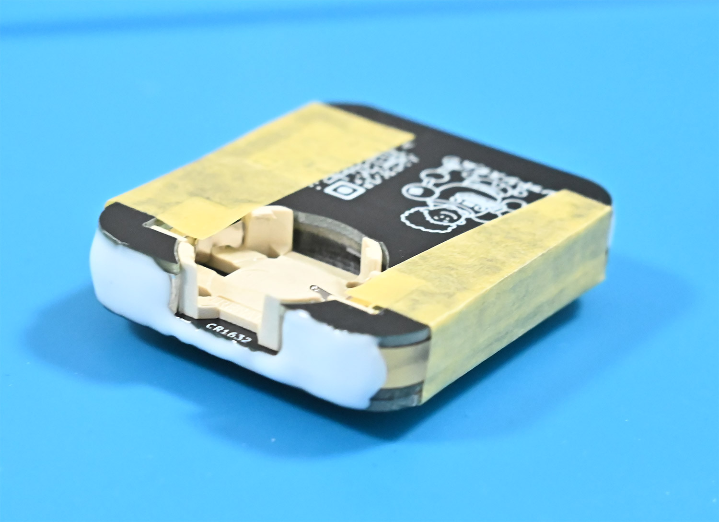
[picture p54: docs/img/azdice_4/build_51.jpg]


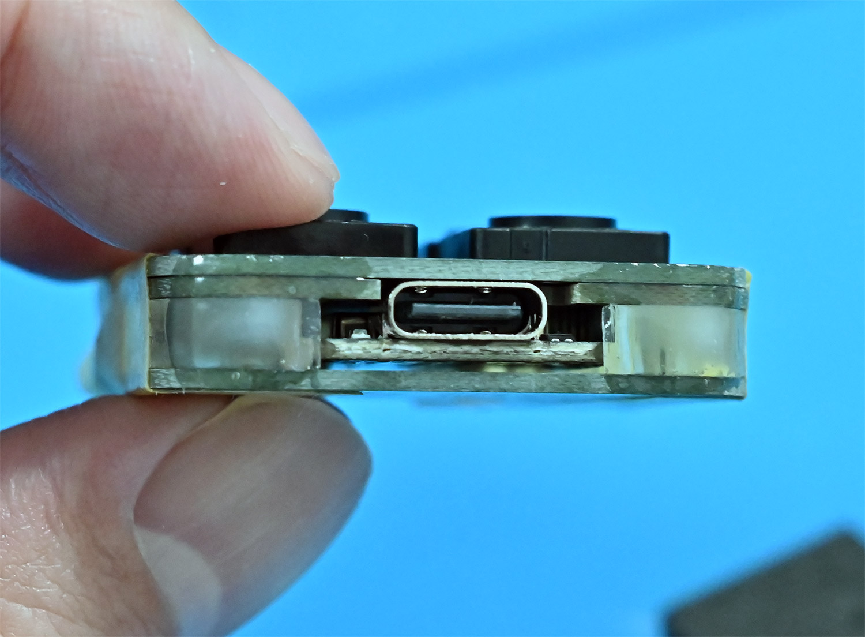
[picture p55: docs/img/azdice_4/build_52.jpg]


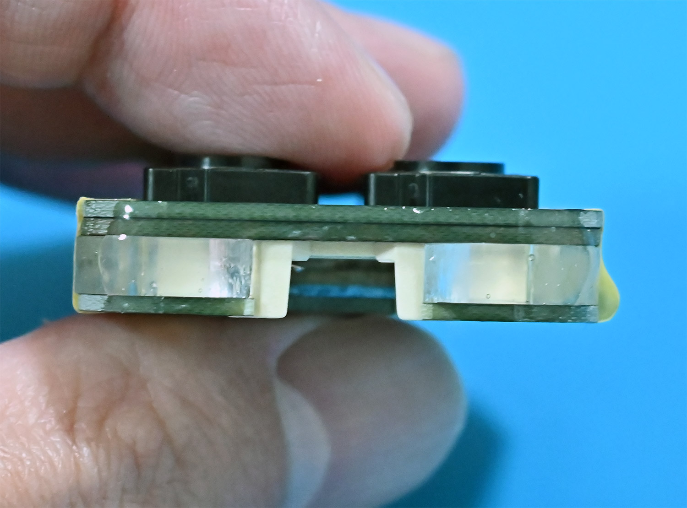
[picture p56: docs/img/azdice_4/build_53.jpg]


乾いたらマスキングテープを剥がして、残りの側面もボンドで固めて乾かして下さい。

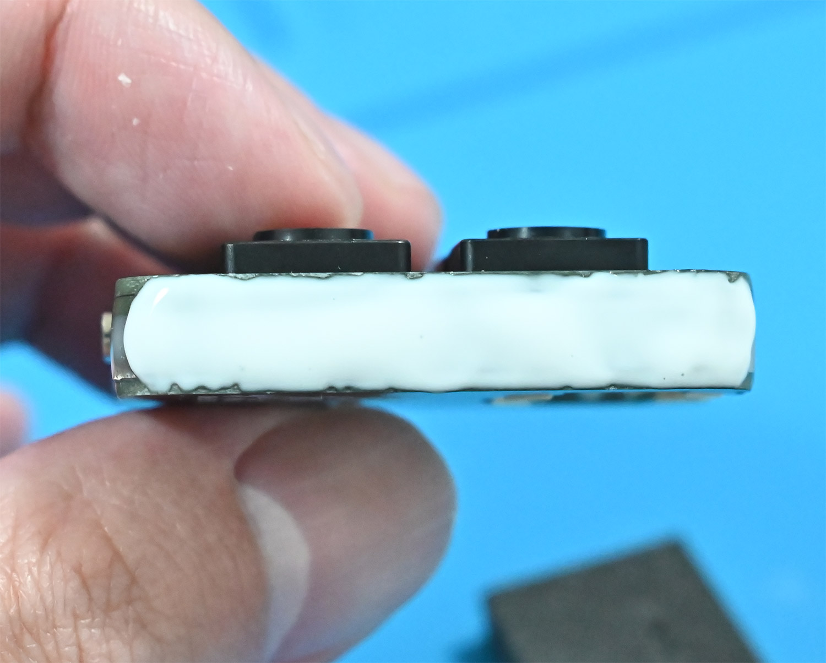
[picture p57: docs/img/azdice_4/build_54.jpg]


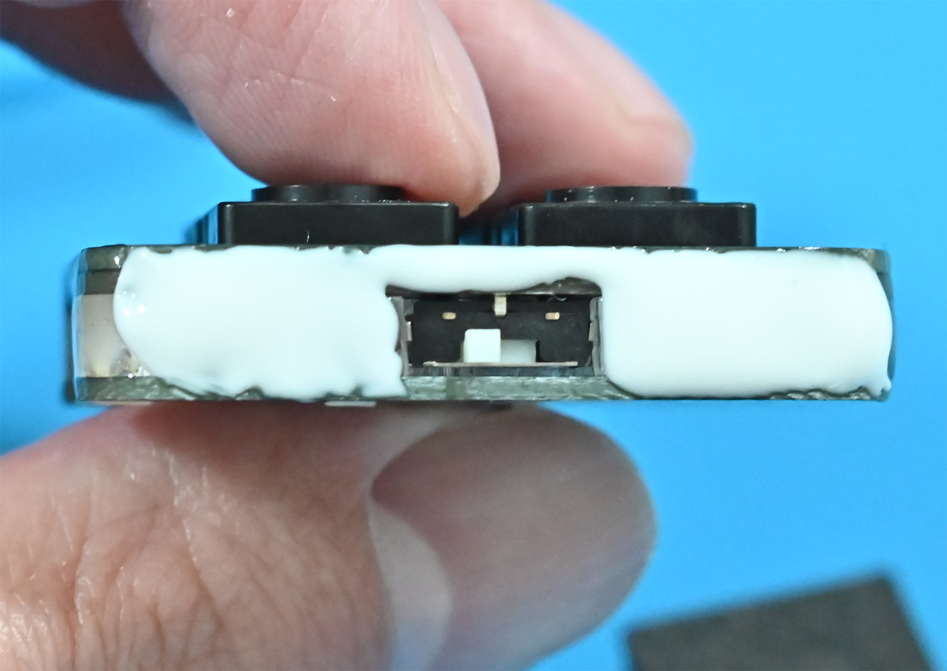
[picture p58: docs/img/azdice_4/build_55.jpg]


乾いたら完成です。

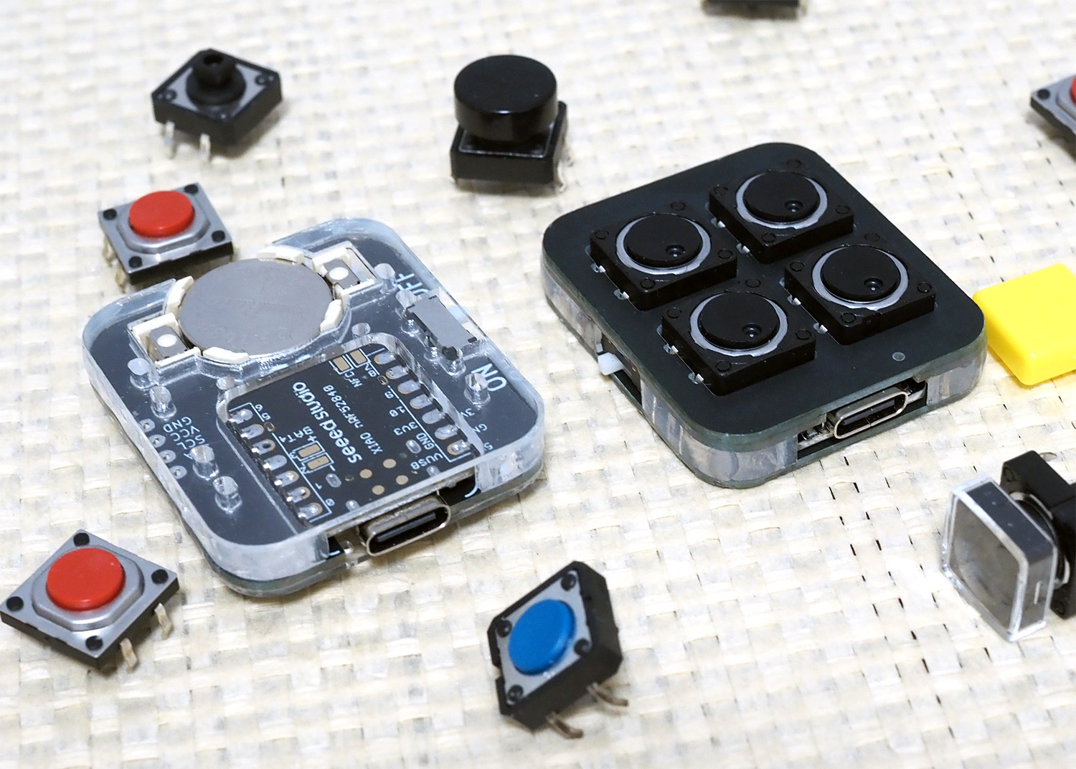
[picture p59: docs/img/azdice_4/azdice_4_main.jpg]


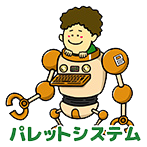
[picture p60: docs/img/logo2.png]
パレットシステム
