palette-system/azdice/(commit log)

2025-12-02 add kicad
    [azdice4.kicad_pcb, azdice4_plate.kicad_pcb, azdice8.kicad_pcb]
2025-12-23 ビルドガイド追加
